prestofuoco/CUTIE-ZEST/pcb/CUTIE-ZEST.pdf

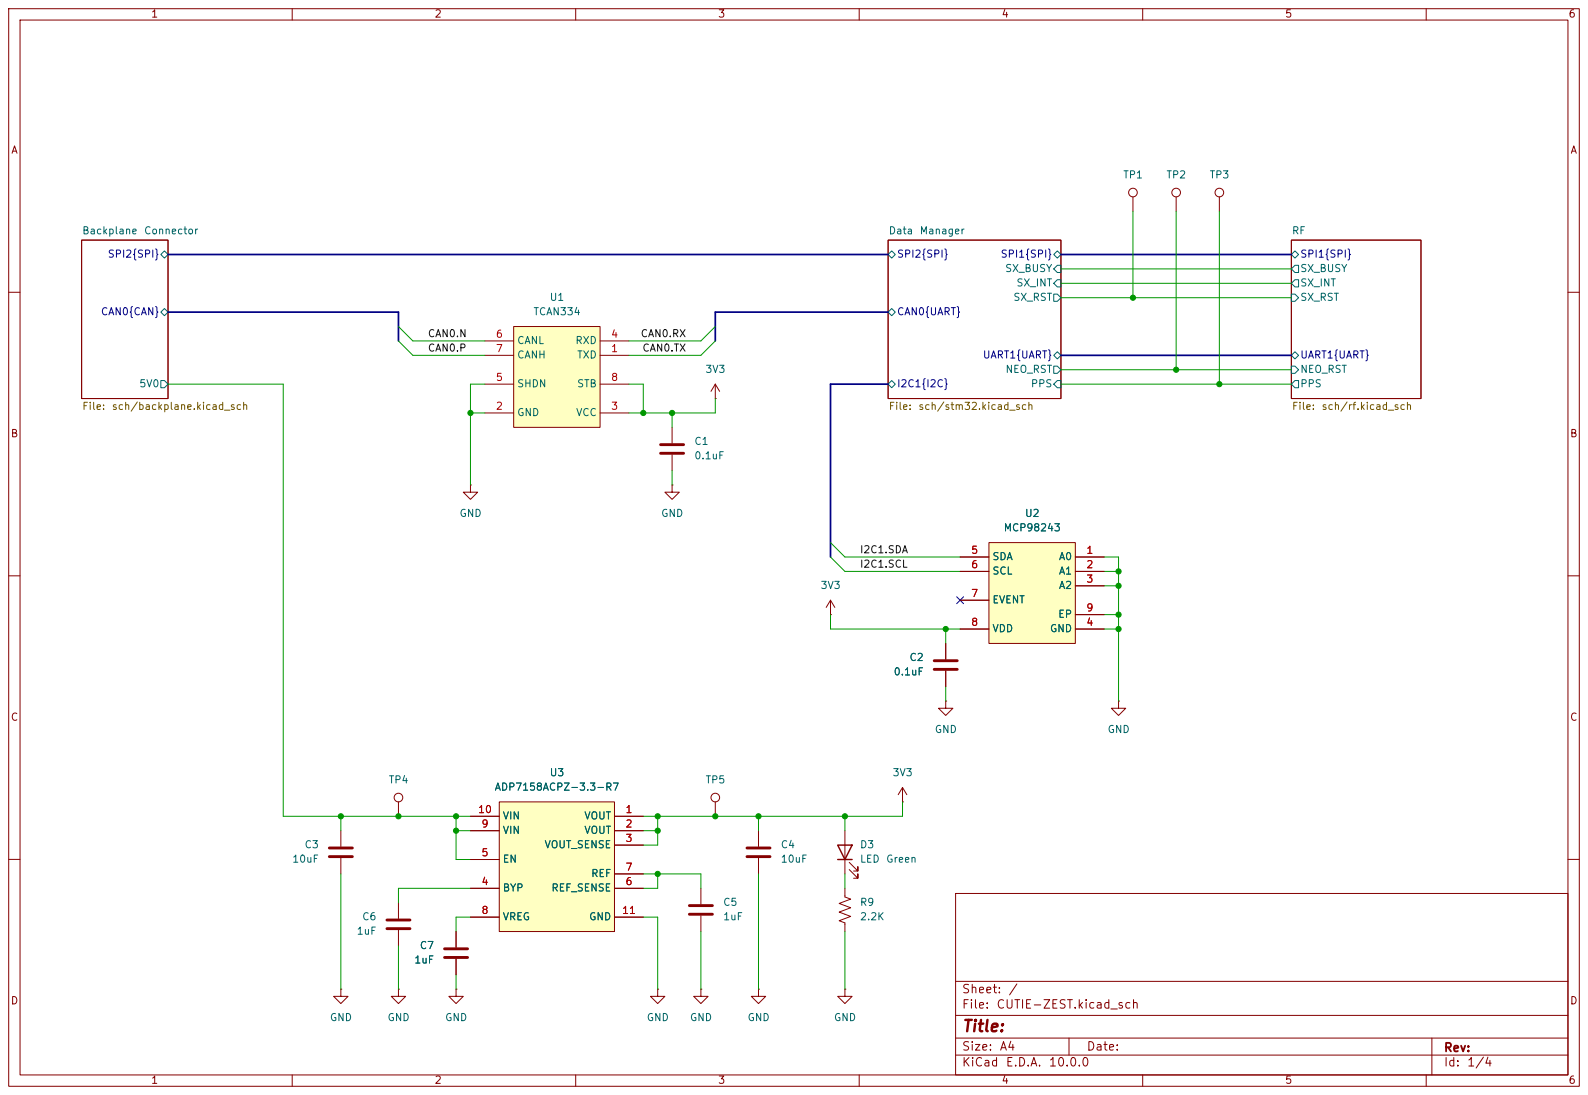
[picture p1: page 1]

SPI1{SPI} SX_BUSY SX_INT SX_RST NEO_RST PPS UART1{UART} RF

Size: A4 | Rev:
KiCad E.D.A. 10.0.0 | Id: 1/4

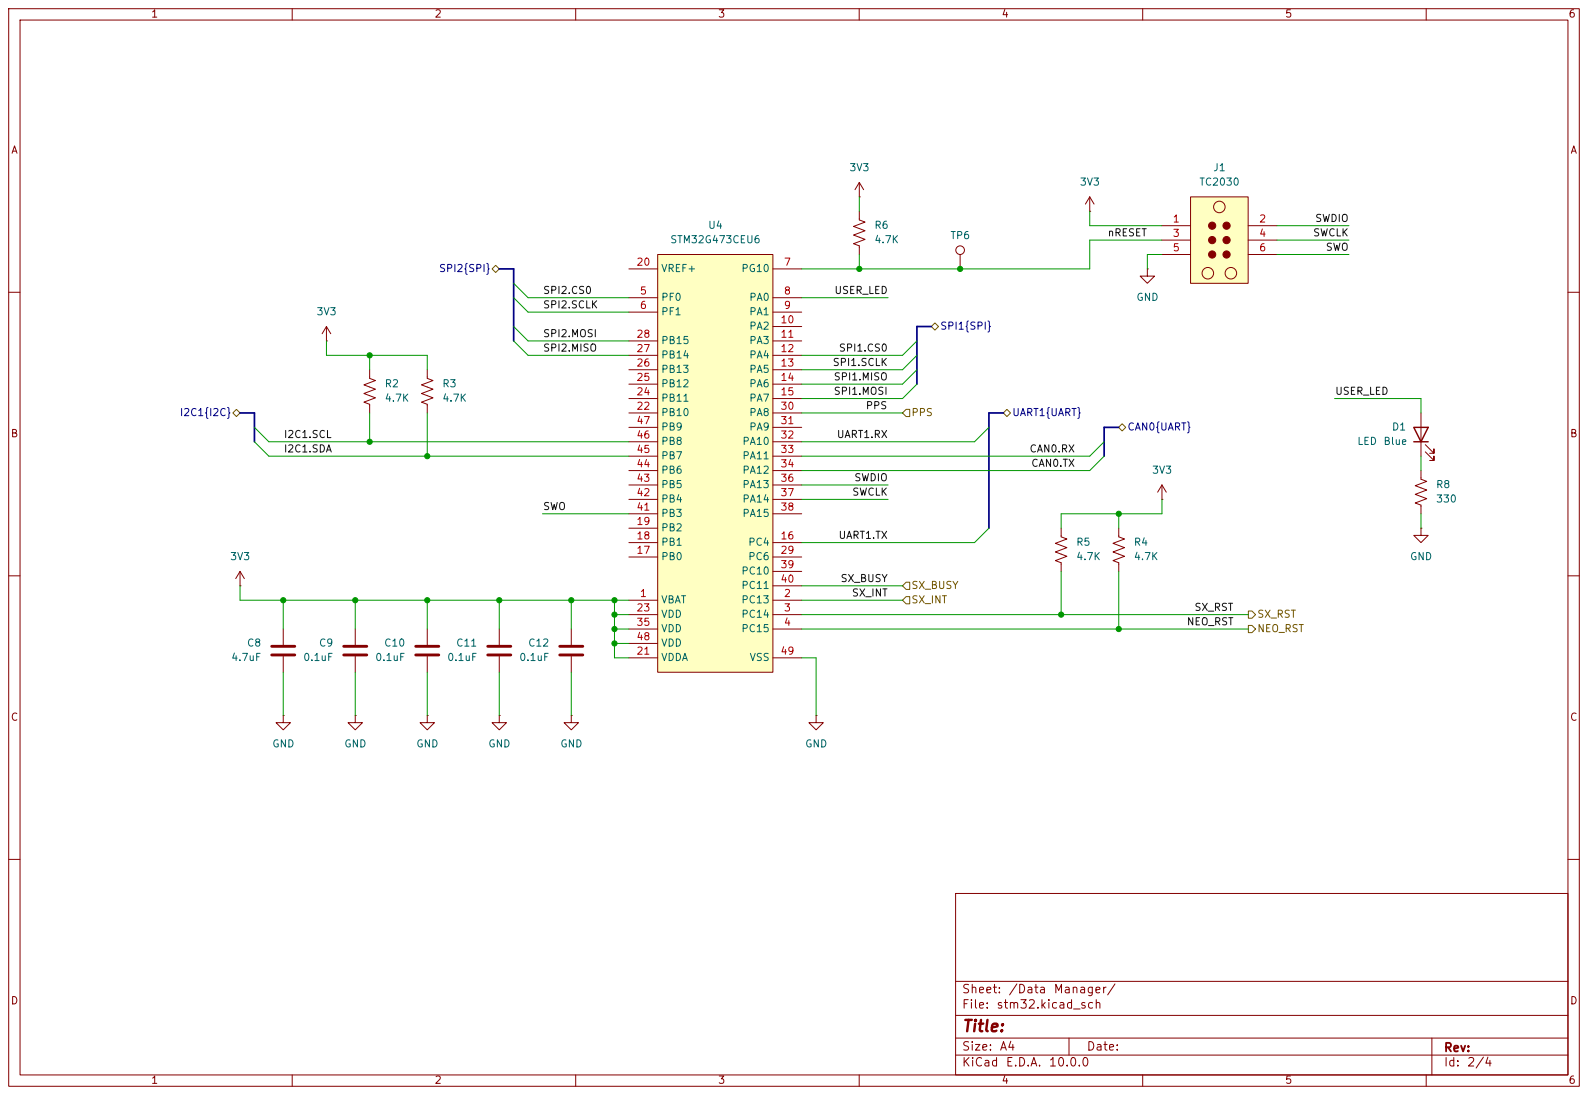
[picture p2: page 2]

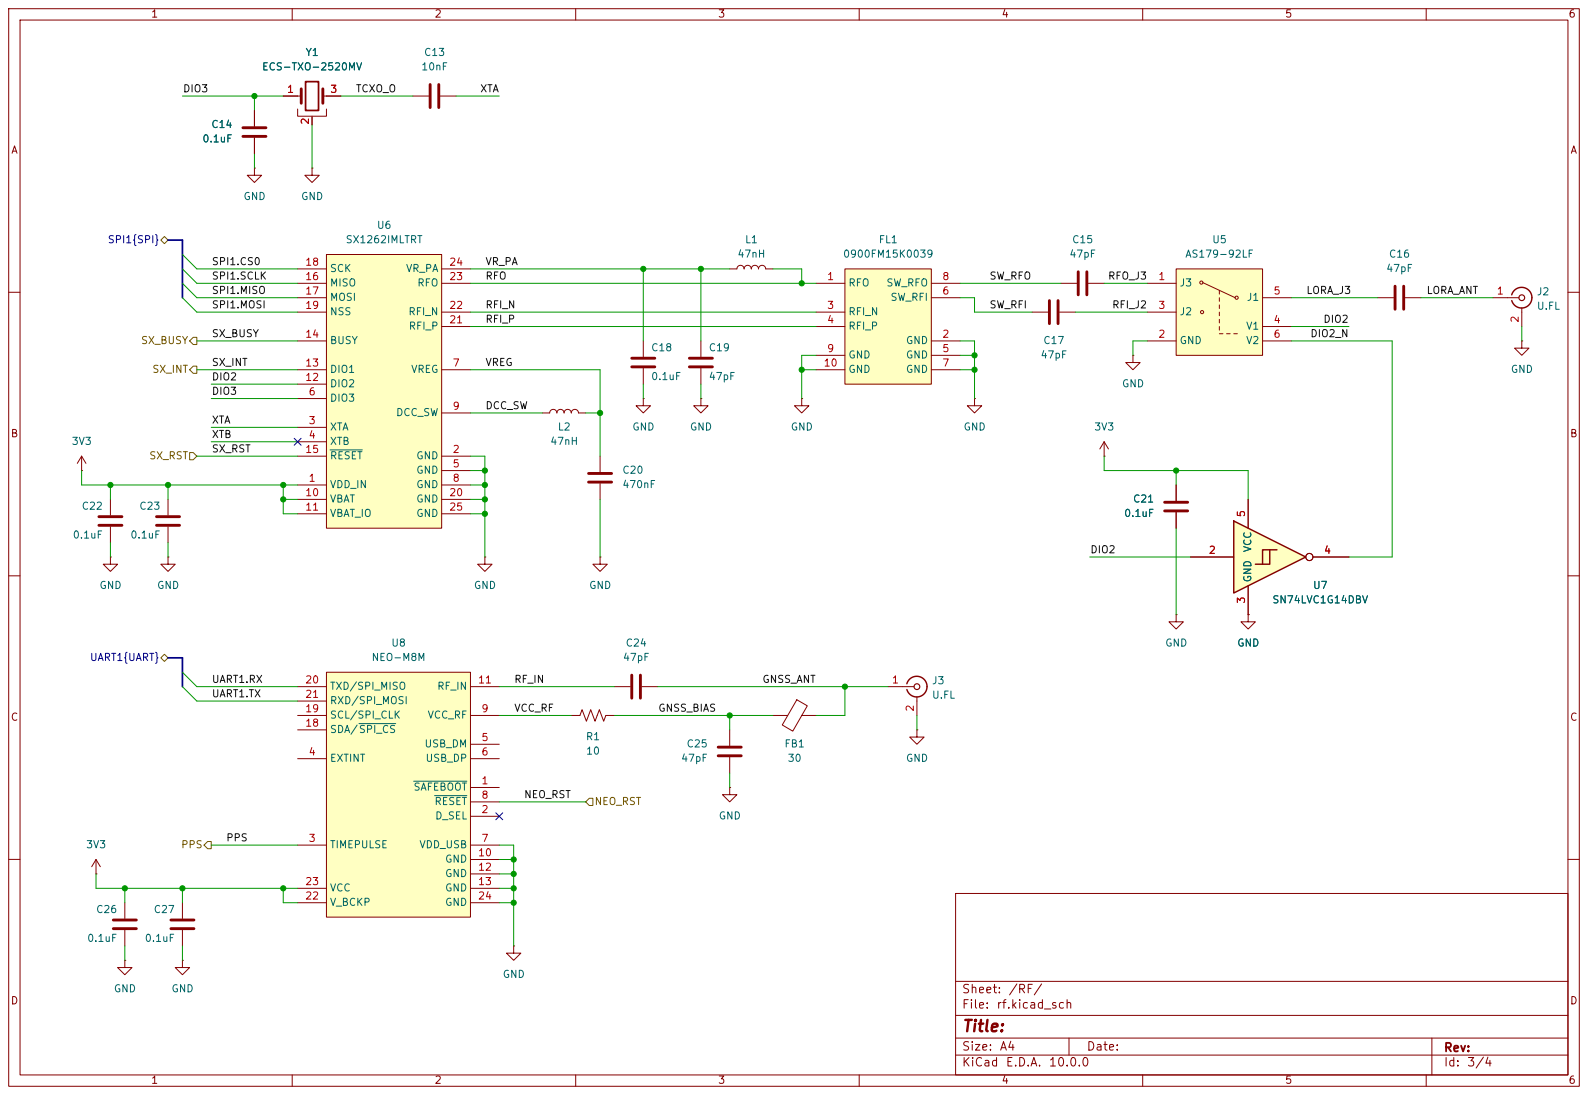
[picture p3: page 3]

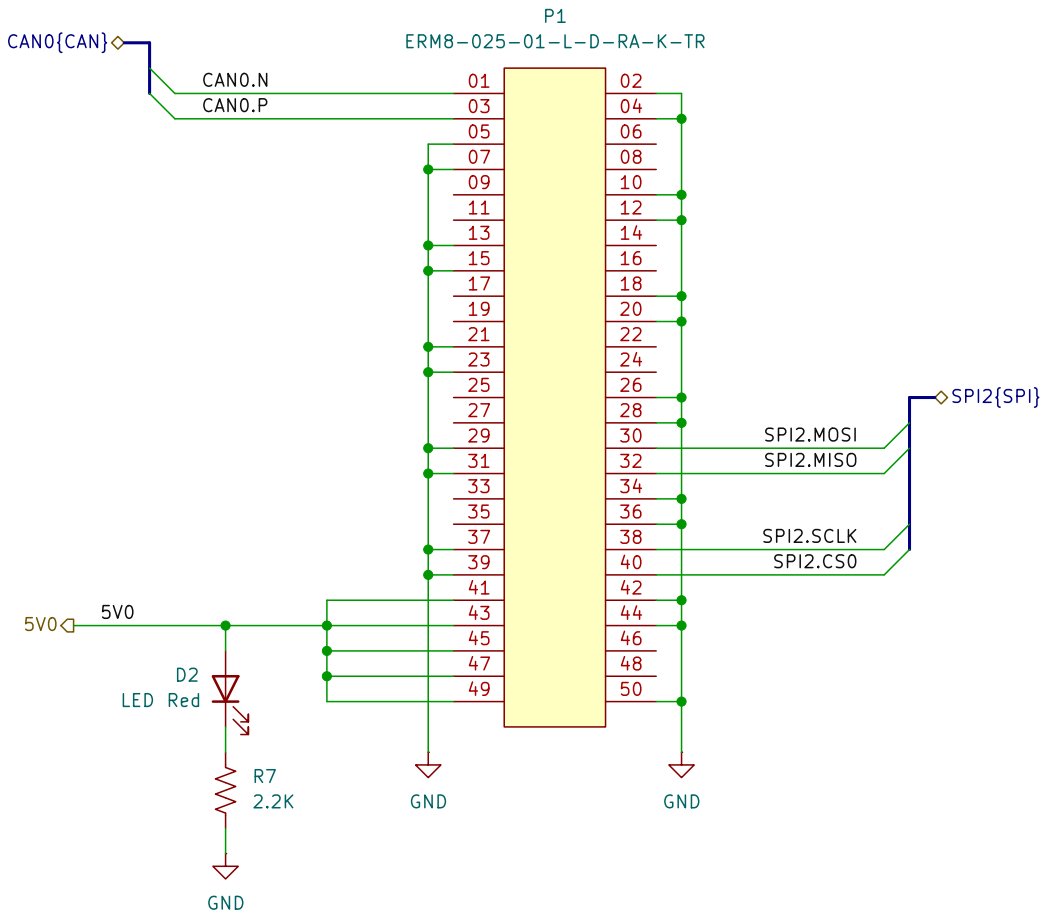
[picture p4: page 4]

39 | 40
41 | 42
