prestofuoco/CUTIE-ZEST/pcb/CUTIE-ZEST.kicad_pcb

## KiCad design pcb/CUTIE-ZEST.kicad_pcb (2026-04-08)

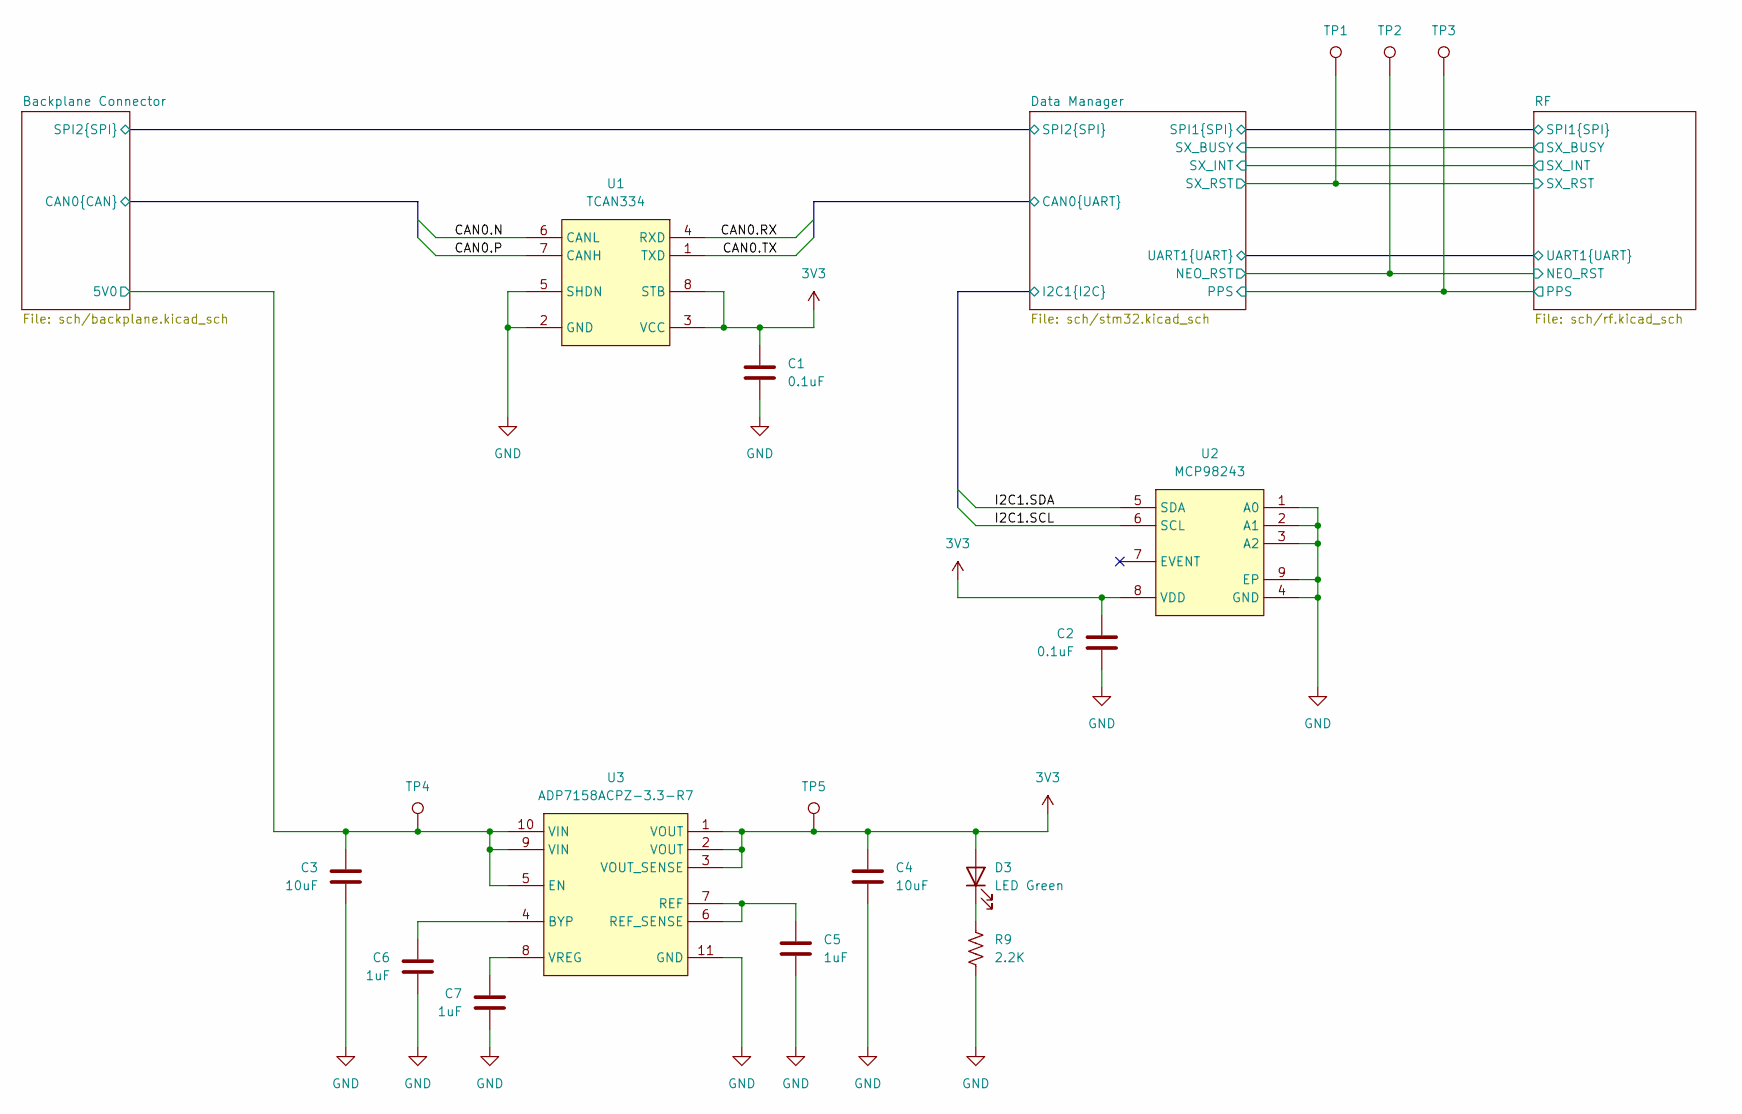
[picture p5: schematic CUTIE-ZEST.kicad_sch]

Parts:
C1, C2: 0.1uF; C_0402_1005Metric
C3, C4: 10uF; C_0603_1608Metric
C5, C6, C7: 1uF; C_0603_1608Metric
D3: LED Green; LED_0805_2012Metric
R9: 2.2K; R_0402_1005Metric
TP1, TP2, TP3, TP4, TP5: TestPoint; TestPoint_Pad_D1.0mm
U1: TCAN334; JEITA_SOIC-8_3.9x4.9mm_P1.27mm
U2: MCP98243; DFN-8-1EP_3x2mm_P0.5mm_EP1.3x1.5mm
U3: ADP7158ACPZ-3.3-R7; CP-10-9_ADI

Connections:
3V3: C1.1, C2.1, C4.1, D3.2 (A), TP5.1 (1_1), U1.3 (VCC), U1.8 (STB), U2.8 (VDD), U3.1 (VOUT), U3.2 (VOUT), U3.3 (VOUT_SENSE); also elsewhere on the board
/Backplane Connector/5V0: C3.1, TP4.1 (1_1), U3.5 (EN), U3.9 (VIN), U3.10 (VIN); also elsewhere on the board
/Backplane Connector/CAN0.N: U1.6 (CANL); also elsewhere on the board
/Backplane Connector/CAN0.P: U1.7 (CANH); also elsewhere on the board
/Data Manager/CAN0.RX: U1.4 (RXD); also elsewhere on the board
/Data Manager/CAN0.TX: U1.1 (TXD); also elsewhere on the board
/Data Manager/I2C1.SCL: U2.6 (SCL); also elsewhere on the board
/Data Manager/I2C1.SDA: U2.5 (SDA); also elsewhere on the board
/Data Manager/NEO_RST: TP2.1 (1_1); also elsewhere on the board
/Data Manager/PPS: TP3.1 (1_1); also elsewhere on the board
/Data Manager/SX_RST: TP1.1 (1_1); also elsewhere on the board
GND: C1.2, C2.2, C3.2, C4.2, C5.2, C6.2, C7.2, R9.2, U1.2 (GND), U1.5 (SHDN), U2.1 (A0), U2.2 (A1), U2.3 (A2), U2.4 (GND), U2.9 (EP), U3.11 (GND); also elsewhere on the board
unnamed: D3.1 (K), R9.1
unnamed: C6.1, U3.4 (BYP)
unnamed: C5.1, U3.6 (REF_SENSE), U3.7 (REF)
unnamed: C7.1, U3.8 (VREG)

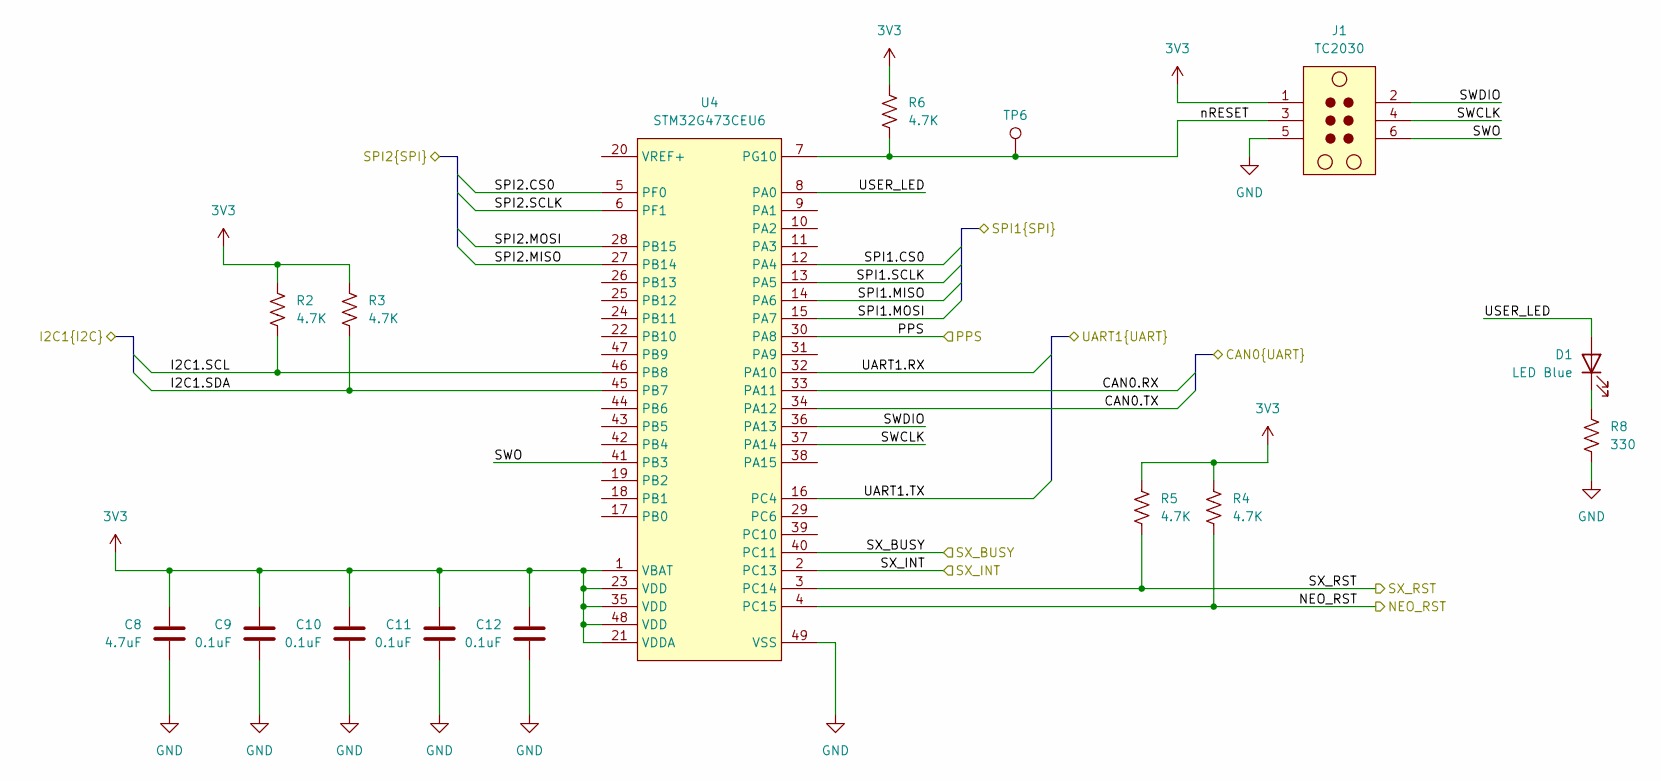
[picture p6: schematic stm32.kicad_sch]

Parts:
C8: 4.7uF; C_0603_1608Metric
C9, C10, C11, C12: 0.1uF; C_0402_1005Metric
D1: LED Blue; LED_0805_2012Metric
J1: TC2030; Tag-Connect_TC2030-IDC-NL_2x03_P1.27mm_Vertical
R2, R3, R4, R5, R6: 4.7K; R_0402_1005Metric
R8: 330; R_0402_1005Metric
TP6: TestPoint; TestPoint_Pad_D1.0mm
U4: STM32G473CEU6; QFN-48-1EP_7x7mm_P0.5mm_EP5.6x5.6mm

Connections:
3V3: C8.1, C9.1, C10.1, C11.1, C12.1, J1.1, R2.1, R3.1, R4.1, R5.1, R6.1, U4.1 (VBAT), U4.21 (VDDA), U4.23 (VDD), U4.35 (VDD), U4.48 (VDD); also elsewhere on the board
/Backplane Connector/SPI2.CS0: U4.5 (PF0); also elsewhere on the board
/Backplane Connector/SPI2.MISO: U4.27 (PB14); also elsewhere on the board
/Backplane Connector/SPI2.MOSI: U4.28 (PB15); also elsewhere on the board
/Backplane Connector/SPI2.SCLK: U4.6 (PF1); also elsewhere on the board
/Data Manager/CAN0.RX: U4.33 (PA11); also elsewhere on the board
/Data Manager/CAN0.TX: U4.34 (PA12); also elsewhere on the board
/Data Manager/I2C1.SCL: R2.2, U4.46 (PB8); also elsewhere on the board
/Data Manager/I2C1.SDA: R3.2, U4.45 (PB7); also elsewhere on the board
/Data Manager/NEO_RST: R4.2, U4.4 (PC15); also elsewhere on the board
/Data Manager/PPS: U4.30 (PA8); also elsewhere on the board
/Data Manager/SPI1.CS0: U4.12 (PA4); also elsewhere on the board
/Data Manager/SPI1.MISO: U4.14 (PA6); also elsewhere on the board
/Data Manager/SPI1.MOSI: U4.15 (PA7); also elsewhere on the board
/Data Manager/SPI1.SCLK: U4.13 (PA5); also elsewhere on the board
/Data Manager/SWCLK: J1.4, U4.37 (PA14)
/Data Manager/SWDIO: J1.2, U4.36 (PA13)
/Data Manager/SWO: J1.6, U4.41 (PB3)
/Data Manager/SX_BUSY: U4.40 (PC11); also elsewhere on the board
/Data Manager/SX_INT: U4.2 (PC13); also elsewhere on the board
/Data Manager/SX_RST: R5.2, U4.3 (PC14); also elsewhere on the board
/Data Manager/UART1.RX: U4.32 (PA10); also elsewhere on the board
/Data Manager/UART1.TX: U4.16 (PC4); also elsewhere on the board
/Data Manager/USER_LED: D1.2 (A), U4.8 (PA0)
/Data Manager/nRESET: J1.3, R6.2, TP6.1 (1_1), U4.7 (PG10)
GND: C8.2, C9.2, C10.2, C11.2, C12.2, J1.5, R8.2, U4.49 (VSS); also elsewhere on the board
unnamed: D1.1 (K), R8.1

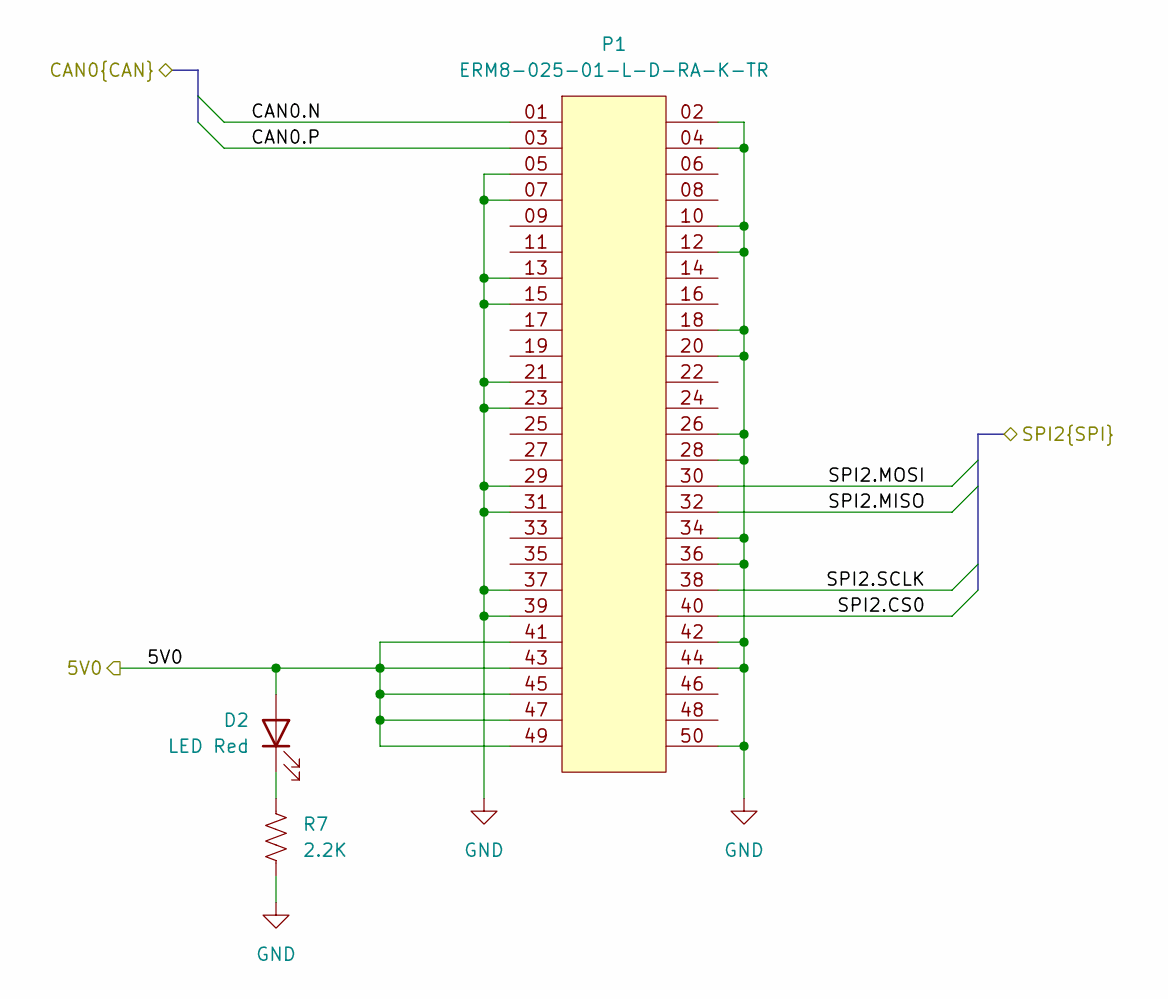
[picture p7: schematic backplane.kicad_sch]

Parts:
D2: LED Red; LED_0805_2012Metric
P1: ERM8-025-01-L-D-RA-K-TR; SAMTEC_ERM8-025-XX-X-D-RA-XX
R7: 2.2K; R_0402_1005Metric

Connections:
/Backplane Connector/5V0: D2.2 (A), P1.41, P1.43, P1.45, P1.47, P1.49; also elsewhere on the board
/Backplane Connector/CAN0.N: P1.01; also elsewhere on the board
/Backplane Connector/CAN0.P: P1.03; also elsewhere on the board
/Backplane Connector/SPI2.CS0: P1.40; also elsewhere on the board
/Backplane Connector/SPI2.MISO: P1.32; also elsewhere on the board
/Backplane Connector/SPI2.MOSI: P1.30; also elsewhere on the board
/Backplane Connector/SPI2.SCLK: P1.38; also elsewhere on the board
GND: P1.02, P1.04, P1.05, P1.07, P1.10, P1.12, P1.13, P1.15, P1.18, P1.20, P1.21, P1.23, P1.26, P1.28, P1.29, P1.31, P1.34, P1.36, P1.37, P1.39, P1.42, P1.44, P1.50, R7.2; also elsewhere on the board
unnamed: D2.1 (K), R7.1

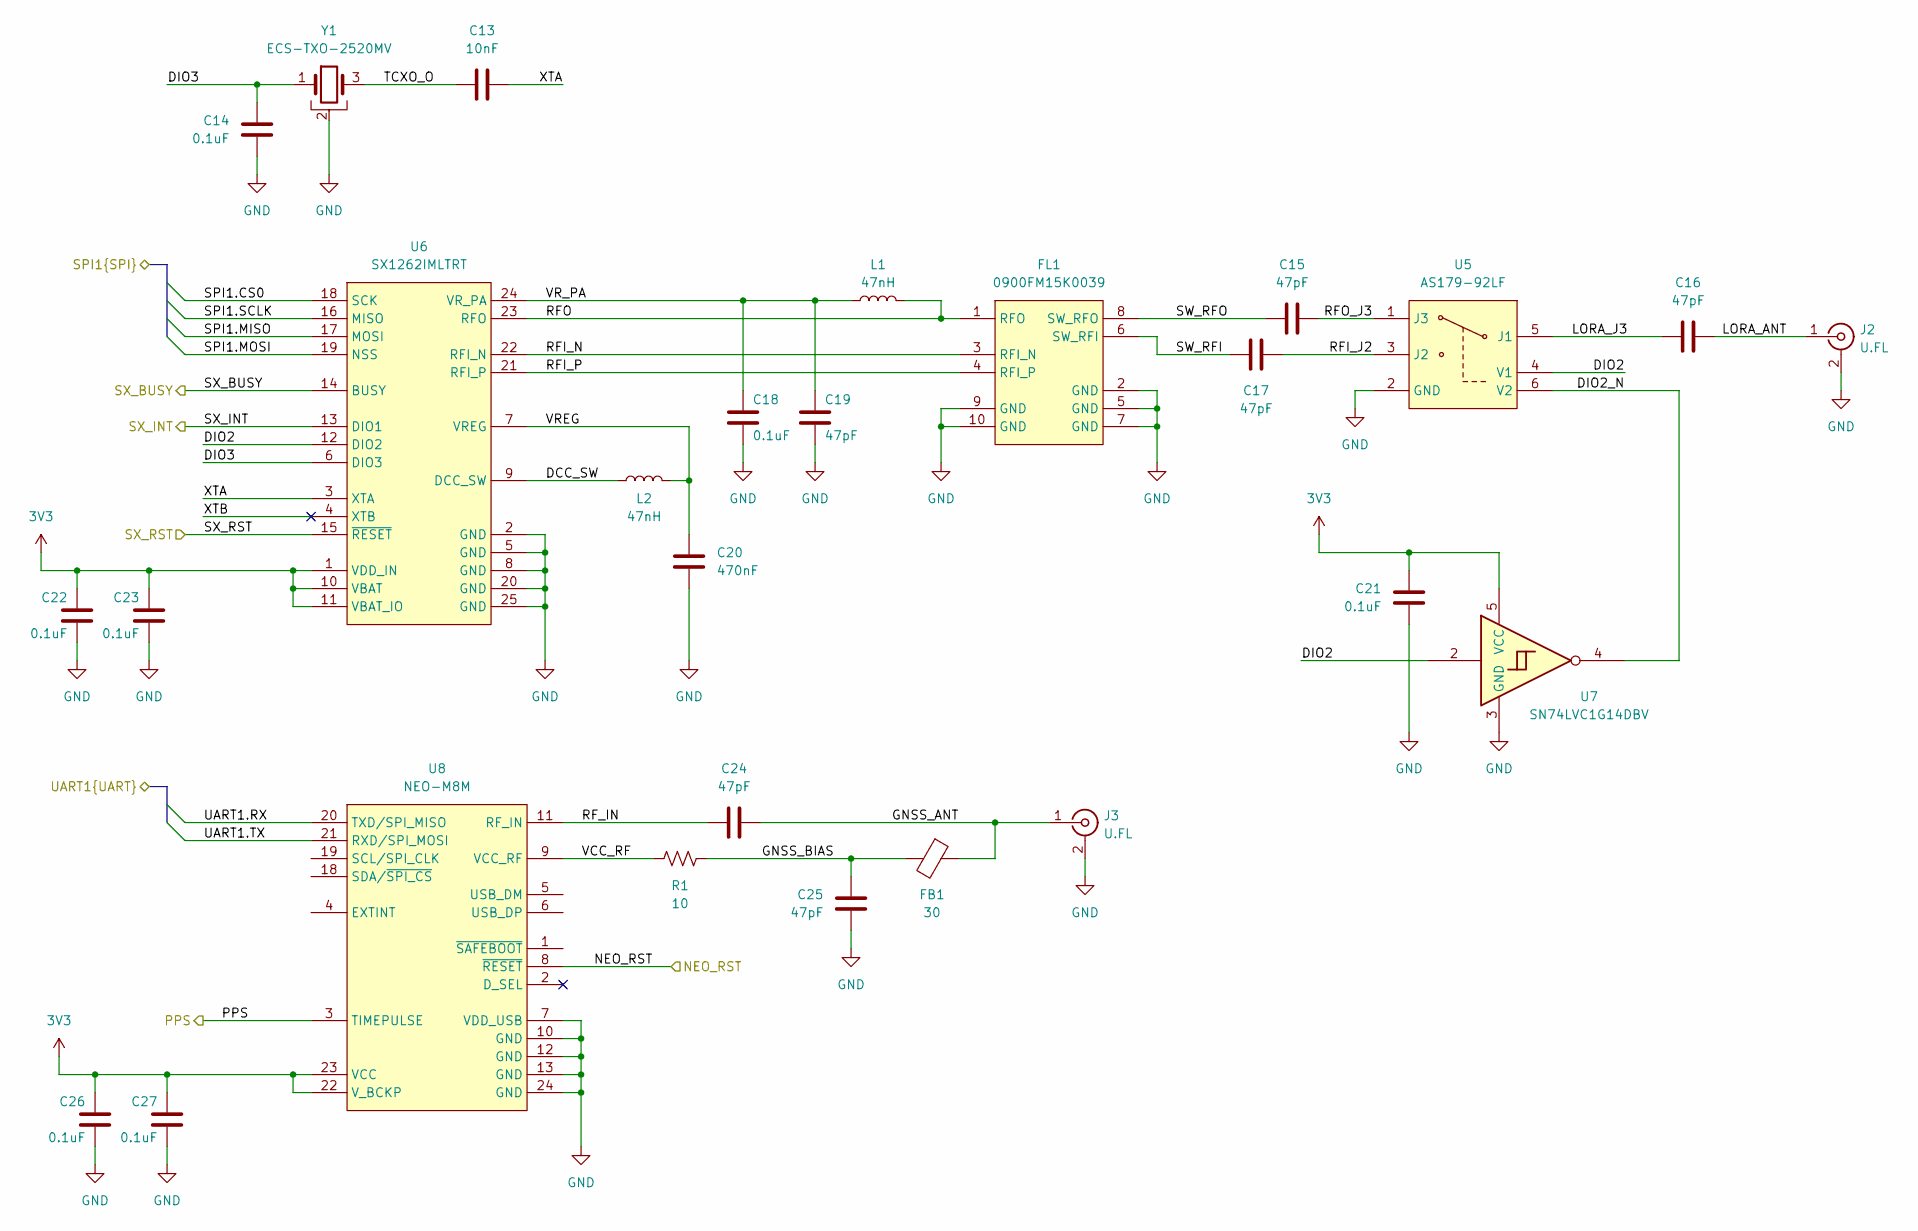
[picture p8: schematic rf.kicad_sch]

Parts:
C13: 10nF; C_0402_1005Metric
C14, C18, C21, C22, C23, C26, C27: 0.1uF; C_0402_1005Metric
C15, C16, C17, C19, C24, C25: 47pF; C_0402_1005Metric
C20: 470nF; C_0402_1005Metric
FB1: 30; L_0805_2012Metric
FL1: 0900FM15K0039; Balun_Johanson_0900FM15K0039
J2, J3: U.FL; U.FL_Hirose_U.FL-R-SMT-1_Vertical
L1, L2: 47nH; L_0402_1005Metric
R1: 10; R_0402_1005Metric
U5: AS179-92LF; SOT-363_SC-70-6
U6: SX1262IMLTRT; QFN-24-1EP_4x4mm_P0.5mm_EP2.6x2.6mm
U7: SN74LVC1G14DBV; SOT-23-5
U8: NEO-M8M; ublox_NEO
Y1: ECS-TXO-2520MV; Crystal_SMD_2520-4Pin_2.5x2.0mm

Connections:
3V3: C21.1, C22.1, C23.1, C26.1, C27.1, U6.1 (VDD_IN), U6.10 (VBAT), U6.11 (VBAT_IO), U7.5 (VCC), U8.22 (V_BCKP), U8.23 (VCC); also elsewhere on the board
/Data Manager/NEO_RST: U8.8 (~RESET); also elsewhere on the board
/Data Manager/PPS: U8.3 (TIMEPULSE); also elsewhere on the board
/Data Manager/SPI1.CS0: U6.18 (SCK); also elsewhere on the board
/Data Manager/SPI1.MISO: U6.17 (MOSI); also elsewhere on the board
/Data Manager/SPI1.MOSI: U6.19 (NSS); also elsewhere on the board
/Data Manager/SPI1.SCLK: U6.16 (MISO); also elsewhere on the board
/Data Manager/SX_BUSY: U6.14 (BUSY); also elsewhere on the board
/Data Manager/SX_INT: U6.13 (DIO1); also elsewhere on the board
/Data Manager/SX_RST: U6.15 (~RESET); also elsewhere on the board
/Data Manager/UART1.RX: U8.20 (TXD/SPI_MISO); also elsewhere on the board
/Data Manager/UART1.TX: U8.21 (RXD/SPI_MOSI); also elsewhere on the board
/RF/DCC_SW: L2.1, U6.9 (DCC_SW)
/RF/DIO2: U5.4 (V1), U6.12 (DIO2), U7.2
/RF/DIO2_N: U5.6 (V2), U7.4
/RF/DIO3: C14.1, U6.6 (DIO3), Y1.1, Y1.4
/RF/GNSS_ANT: C24.2, FB1.1, J3.1 (In)
/RF/GNSS_BIAS: C25.1, FB1.2, R1.2
/RF/LORA_ANT: C16.2, J2.1 (In)
/RF/LORA_J3: C16.1, U5.5 (J1)
/RF/RFI_J2: C17.2, U5.3 (J2)
/RF/RFI_N: FL1.3 (RFI_N), U6.22 (RFI_N)
/RF/RFI_P: FL1.4 (RFI_P), U6.21 (RFI_P)
/RF/RFO: FL1.1 (RFO), L1.2, U6.23 (RFO)
/RF/RFO_J3: C15.2, U5.1 (J3)
/RF/RF_IN: C24.1, U8.11 (RF_IN)
/RF/SW_RFI: C17.1, FL1.6 (SW_RFI)
/RF/SW_RFO: C15.1, FL1.8 (SW_RFO)
/RF/TCXO_O: C13.1, Y1.3
/RF/VCC_RF: R1.1, U8.9 (VCC_RF)
/RF/VREG: C20.1, L2.2, U6.7 (VREG)
/RF/VR_PA: C18.1, C19.1, L1.1, U6.24 (VR_PA)
/RF/XTA: C13.2, U6.3 (XTA)
/RF/XTB: U6.4 (XTB)
GND: C14.2, C18.2, C19.2, C20.2, C21.2, C22.2, C23.2, C25.2, C26.2, C27.2, FL1.2 (GND), FL1.5 (GND), FL1.7 (GND), FL1.9 (GND), FL1.10 (GND), J2.2 (Ext), J3.2 (Ext), U5.2 (GND), U6.2 (GND), U6.5 (GND), U6.8 (GND), U6.20 (GND), U6.25 (GND), U7.3 (GND), U8.7 (VDD_USB), U8.10 (GND), U8.12 (GND), U8.13 (GND), U8.24 (GND), Y1.2; also elsewhere on the board

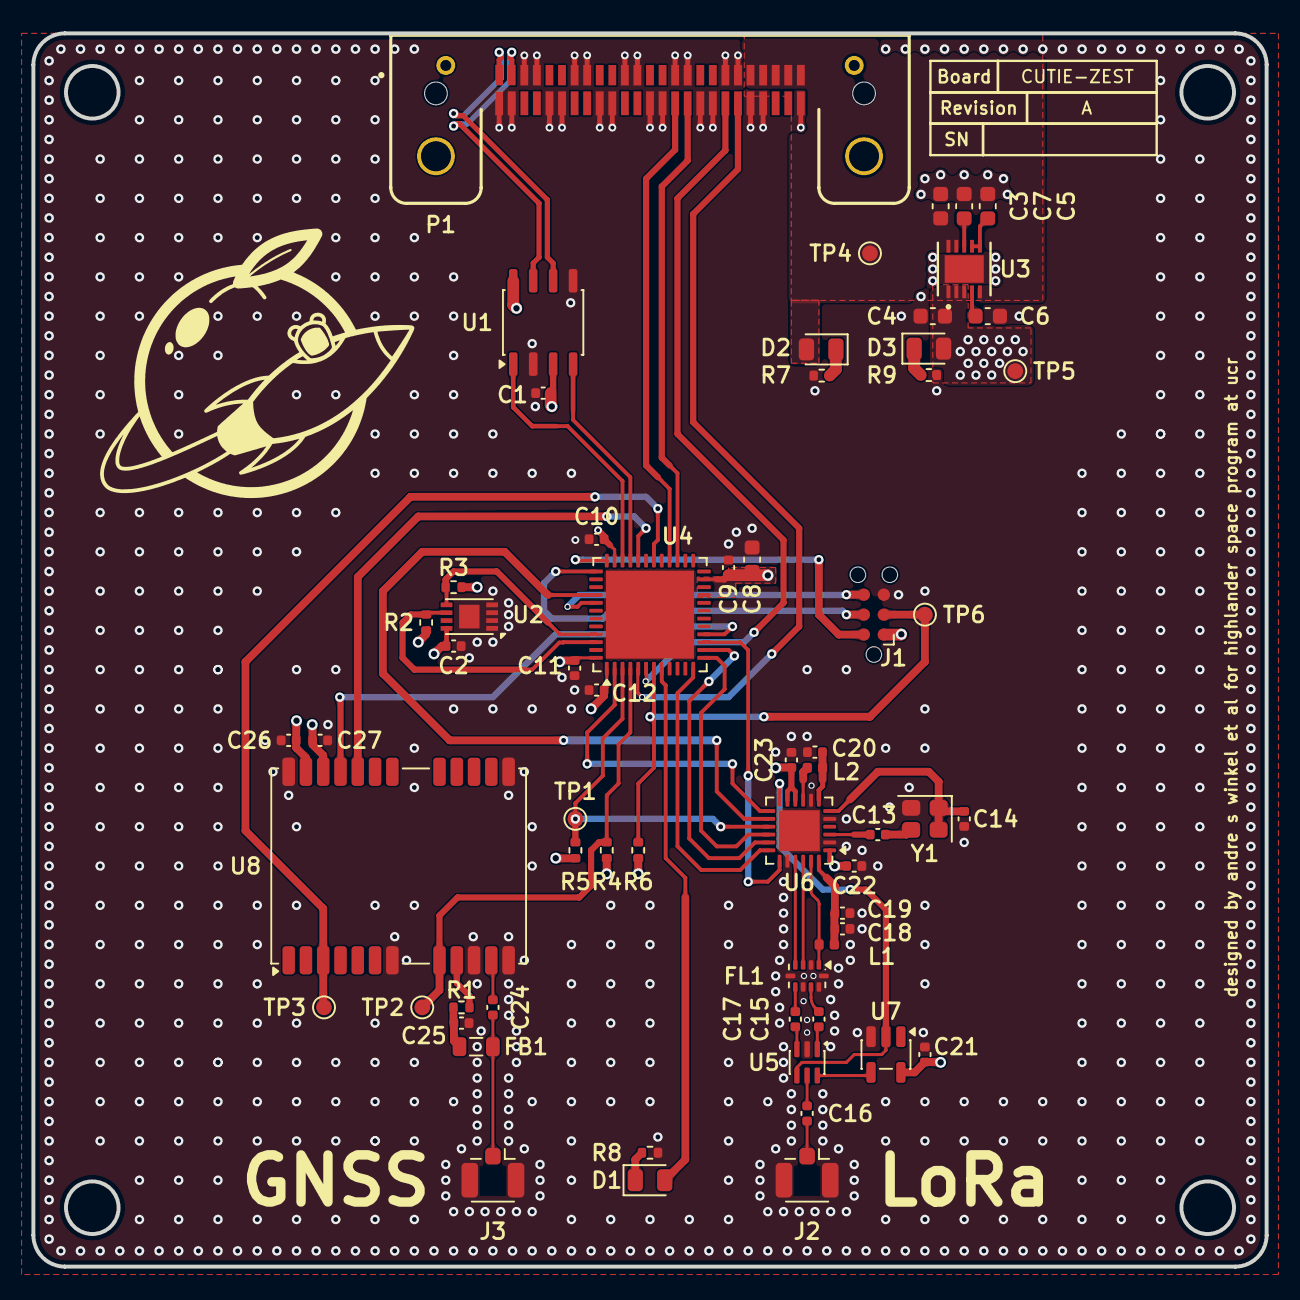
[picture p9: board CUTIE-ZEST.kicad_pcb from above]

Board: 4 copper layers, 78.5 x 78.5 mm, 62 parts (0 on the bottom side), 56 nets.
