prestofuoco/CUTIE-ZEST/src/Core/Src/main.c

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
/* Includes ------------------------------------------------------------------*/
#include "main.h"

/* USER CODE BEGIN Includes */
#include "radio/gps_driver.h"
#include "radio/lora_driver.h"
/* USER CODE END Includes */

FDCAN_HandleTypeDef hfdcan1;

I2C_HandleTypeDef hi2c1;

SPI_HandleTypeDef hspi1;
SPI_HandleTypeDef hspi2;

UART_HandleTypeDef huart1;

void SystemClock_Config(void);
static void MX_GPIO_Init(void);
static void MX_FDCAN1_Init(void);
static void MX_I2C1_Init(void);
static void MX_SPI1_Init(void);
static void MX_SPI2_Init(void);
static void MX_USART1_UART_Init(void);
/**
  * @brief  The application entry point.
  * @retval int
  */
int main(void)
{

  /* MCU Configuration--------------------------------------------------------*/

  /* Reset of all peripherals, Initializes the Flash interface and the Systick. */
  HAL_Init();

  /* Configure the system clock */
  SystemClock_Config();

  /* Initialize all configured peripherals */
  MX_GPIO_Init();
  MX_FDCAN1_Init();
  MX_I2C1_Init();
  MX_SPI1_Init();
  MX_SPI2_Init();
  MX_USART1_UART_Init();
  /* USER CODE BEGIN 2 */
  GPS_Init(&huart1);
  LORA_Init();
  /* USER CODE END 2 */

  /* Infinite loop */
  /* USER CODE BEGIN WHILE */
  while (1) {
    GPS_Process();
    GPS_LED_Tick();
    LORA_Process();

    if (LORA_PacketAvailable()) {
      LORA_Packet_t pkt = LORA_GetLatestPacket();
    }

    // send every 10 seconds
    if (HAL_GetTick() - LORA_GetLastSendTick() >= 10000) {
        GPS_Data_t gps = GPS_GetLatest();
        LORA_Packet_t pkt = {
            .latitude           = gps.latitude,
            .longitude          = gps.longitude,
            .altitude           = gps.altitude,
            .satellites         = gps.satellites,
            .has_fix            = gps.has_fix,
            .battery_percentage = 85,
        };
        LORA_SendPacket(&pkt);
    }
    /* USER CODE BEGIN 3 */
  }
  /* USER CODE END 3 */
}

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
