prestofuoco/CUTIE-ZEST/src/src.ioc

Mcu.UserName=STM32G473CEUx
PA0.GPIO_Label=USER_LED
PA0.Signal=GPIO_Output
PA10.Signal=USART1_RX
PA11.Signal=FDCAN1_RX
PA12.Signal=FDCAN1_TX
PA13.Signal=SYS_JTMS-SWDIO
PA14.Signal=SYS_JTCK-SWCLK
PA4.GPIO_Label=SPI1_CS0
PA4.Signal=GPIO_Output
PA5.Signal=SPI1_SCK
PA6.Signal=SPI1_MISO
PA7.Signal=SPI1_MOSI
PA8.GPIO_Label=PPS
PA8.Signal=GPIO_Input
PB14.Signal=SPI2_MISO
PB15.Signal=SPI2_MOSI
PB3.Signal=SYS_JTDO-SWO
PB7.Signal=I2C1_SDA
PB8-BOOT0.Signal=I2C1_SCL
PC11.GPIO_Label=SX_BUSY
PC11.Signal=GPIO_Input
PC13.GPIO_Label=SX_INT
PC13.Signal=GPIO_Input
PC14-OSC32_IN.GPIO_Label=SX_RST
PC14-OSC32_IN.Signal=GPIO_Output
PC15-OSC32_OUT.GPIO_Label=NEO_RST
PC15-OSC32_OUT.Signal=GPIO_Output
PC4.Signal=USART1_TX
PF0-OSC_IN.GPIO_Label=SPI2_CS0
PF0-OSC_IN.Signal=GPIO_Output
PF1-OSC_OUT.Signal=SPI2_SCK
PG10-NRST.GPIO_Label=NRST
PG10-NRST.Signal=GPIO_Input
