prestofuoco/CUTIE-ZEST/src/Core/Inc/main.h

#define SX_INT_Pin GPIO_PIN_13
#define SX_INT_GPIO_Port GPIOC
#define SX_RST_Pin GPIO_PIN_14
#define SX_RST_GPIO_Port GPIOC
#define NEO_RST_Pin GPIO_PIN_15
#define NEO_RST_GPIO_Port GPIOC
#define SPI2_CS0_Pin GPIO_PIN_0
#define SPI2_CS0_GPIO_Port GPIOF
#define NRST_Pin GPIO_PIN_10
#define NRST_GPIO_Port GPIOG
#define USER_LED_Pin GPIO_PIN_0
#define USER_LED_GPIO_Port GPIOA
#define SPI1_CS0_Pin GPIO_PIN_4
#define SPI1_CS0_GPIO_Port GPIOA
#define PPS_Pin GPIO_PIN_8
#define PPS_GPIO_Port GPIOA
#define SX_BUSY_Pin GPIO_PIN_11
#define SX_BUSY_GPIO_Port GPIOC
