prestofuoco/CUTIE-ZEST/(commit log)

2026-03-31 update for prod
    [CUTIE-ZEST.kicad_pcb, bom.csv, designators.csv, positions.csv]
2026-04-01 bom for assembly
    [CUTIE-ZEST.csv, CUTIE-ZEST.kicad_sch, backplane.kicad_sch, rf.kicad_sch, stm32.kicad_sch]
2026-04-08 push for fab
    [CUTIE-ZEST.kicad_pcb, stm32.kicad_sch]
2026-04-10 initialized firmware structure
    [CUTIE-ZEST.csv, CUTIE-ZEST.kicad_pcb, CUTIE-ZEST.kicad_sch, backplane.kicad_sch, bom.csv, designators.csv, positions.csv, rf.kicad_sch]
2026-04-14 added driver code for sx126x, minmea
2026-04-25 gps driver receive & processing buffers
2026-04-30 LED Blinking function for connection
2026-05-13 Lora_driver.h and Lora_driver.c
    Updated main and lora drivers.
2026-05-15 Updated changes to Lora Driver
